3hoot/ATT-Turret-System/hardware/ATT.kicad_sch

## KiCad design hardware/ATT.kicad_sch (2026-10-08, an earlier design)

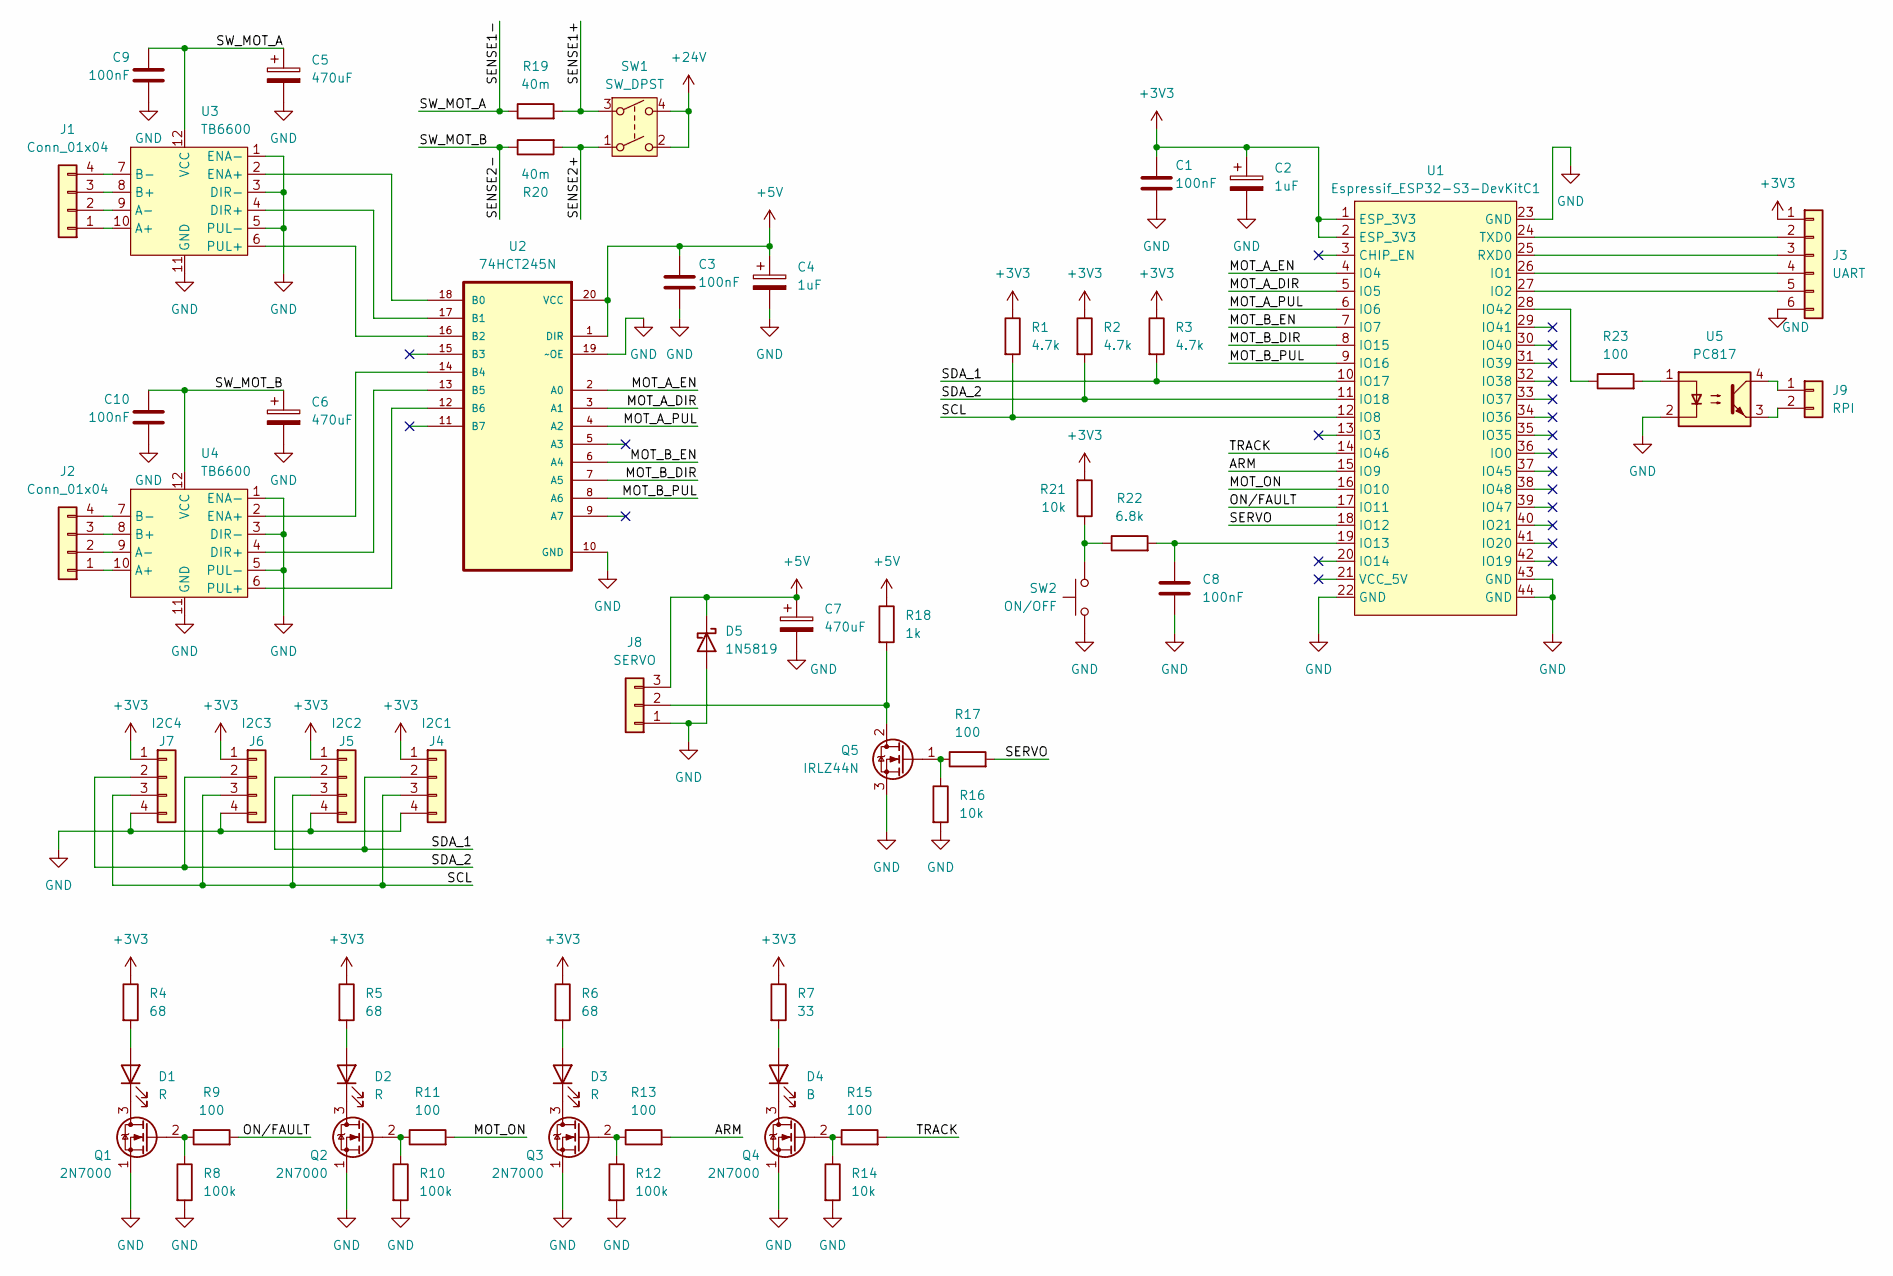
[picture p1: schematic ATT.kicad_sch]

Parts:
C1, C3, C8, C9, C10: 100nF
C2, C4: 1uF
C5, C6, C7: 470uF
D1, D2, D3: R
D4: B
D5: 1N5819; D_DO-41_SOD81_P10.16mm_Horizontal
J1, J2: Conn_01x04
J3: UART
J4: I2C1
J5: I2C2
J6: I2C3
J7: I2C4
J8: SERVO
J9: RPI
Q1, Q2, Q3, Q4: 2N7000; TO-92_Inline
Q5: IRLZ44N; TO-220-3_Vertical
R1, R2, R3: 4.7k
R4, R5, R6: 68
R7: 33
R8, R10, R12: 100k
R9, R11, R13, R15, R17, R23: 100
R14, R16, R21: 10k
R18: 1k
R19, R20: 40m
R22: 6.8k
SW1: SW_DPST
SW2: ON/OFF
U1: Espressif_ESP32-S3-DevKitC1
U2: 74HCT245N; DIP254P762X420-20; MPN 74HCT245N
U3, U4: TB6600
U5: PC817; DIP-4_W7.62mm

Connections:
+3V3: C1.1, C2.1, J3.1, J4.1, J5.1, J6.1, J7.1, R1.1, R2.1, R3.1, R4.1, R5.1, R6.1, R7.1, R21.2, U1.1 (ESP_3V3), U1.2 (ESP_3V3)
+5V: C3.1, C4.1, C7.1, D5.1 (K), J8.3, R18.1, U2.1 (DIR), U2.20 (VCC)
+24V: SW1.2, SW1.4
ARM: R13.2, U1.15 (IO9)
GND: C1.2, C2.2, C3.2, C4.2, C5.2, C6.2, C7.2, C8.2, C9.2, C10.2, D5.2 (A), J3.6, J4.4, J5.4, J6.4, J7.4, J8.1, Q1.1 (S), Q2.1 (S), Q3.1 (S), Q4.1 (S), Q5.3 (S), R8.2, R10.2, R12.2, R14.2, R16.2, SW2.2, U1.22 (GND), U1.23 (GND), U1.43 (GND), U1.44 (GND), U2.10 (GND), U2.19 (~OE), U3.1 (ENA-), U3.3 (DIR-), U3.5 (PUL-), U3.11 (GND), U4.1 (ENA-), U4.3 (DIR-), U4.5 (PUL-), U4.11 (GND), U5.2
MOT_A_DIR: U1.5 (IO5), U2.3 (A1)
MOT_A_EN: U1.4 (IO4), U2.2 (A0)
MOT_A_PUL: U1.6 (IO6), U2.4 (A2)
MOT_B_DIR: U1.8 (IO15), U2.7 (A5)
MOT_B_EN: U1.7 (IO7), U2.6 (A4)
MOT_B_PUL: U1.9 (IO16), U2.8 (A6)
MOT_ON: R11.2, U1.16 (IO10)
unnamed: C8.1, R22.2, U1.19 (IO13)
unnamed: D1.1 (K), Q1.3 (D)
unnamed: D1.2 (A), R4.2
unnamed: D2.1 (K), Q2.3 (D)
unnamed: D2.2 (A), R5.2
unnamed: D3.1 (K), Q3.3 (D)
unnamed: D3.2 (A), R6.2
unnamed: D4.1 (K), Q4.3 (D)
unnamed: D4.2 (A), R7.2
unnamed: J1.1, U3.10 (A+)
unnamed: J1.2, U3.9 (A-)
unnamed: J1.3, U3.8 (B+)
unnamed: J1.4, U3.7 (B-)
unnamed: J2.1, U4.10 (A+)
unnamed: J2.2, U4.9 (A-)
unnamed: J2.3, U4.8 (B+)
unnamed: J2.4, U4.7 (B-)
unnamed: J3.2, U1.24 (TXD0)
unnamed: J3.3, U1.25 (RXD0)
unnamed: J3.4, U1.26 (IO1)
unnamed: J3.5, U1.27 (IO2)
unnamed: J8.2, Q5.2 (D), R18.2
unnamed: J9.1, U5.4
unnamed: J9.2, U5.3
unnamed: Q1.2 (G), R8.1, R9.1
unnamed: Q2.2 (G), R10.1, R11.1
unnamed: Q3.2 (G), R12.1, R13.1
unnamed: Q4.2 (G), R14.1, R15.1
unnamed: Q5.1 (G), R16.1, R17.1
unnamed: R21.1, R22.1, SW2.1
unnamed: R23.1, U1.28 (IO42)
unnamed: R23.2, U5.1
unnamed: U2.12 (B6), U4.6 (PUL+)
unnamed: U2.13 (B5), U4.4 (DIR+)
unnamed: U2.14 (B4), U4.2 (ENA+)
unnamed: U2.16 (B2), U3.6 (PUL+)
unnamed: U2.17 (B1), U3.4 (DIR+)
unnamed: U2.18 (B0), U3.2 (ENA+)
ON/FAULT: R9.2, U1.17 (IO11)
SCL: J4.3, J5.3, J6.3, J7.3, R1.2, U1.12 (IO8)
SDA_1: J4.2, J5.2, R3.2, U1.10 (IO17)
SDA_2: J6.2, J7.2, R2.2, U1.11 (IO18)
SENSE1+: R19.2, SW1.3
SENSE1-: C5.1, C9.1, R19.1, U3.12 (VCC)
SENSE2+: R20.2, SW1.1
SENSE2-: C6.1, C10.1, R20.1, U4.12 (VCC)
SERVO: R17.2, U1.18 (IO12)
TRACK: R15.2, U1.14 (IO46)
