3hoot/ATT-Turret-System/hardware/controller.kicad_sch

## KiCad design hardware/controller.kicad_sch (2026-10-08)

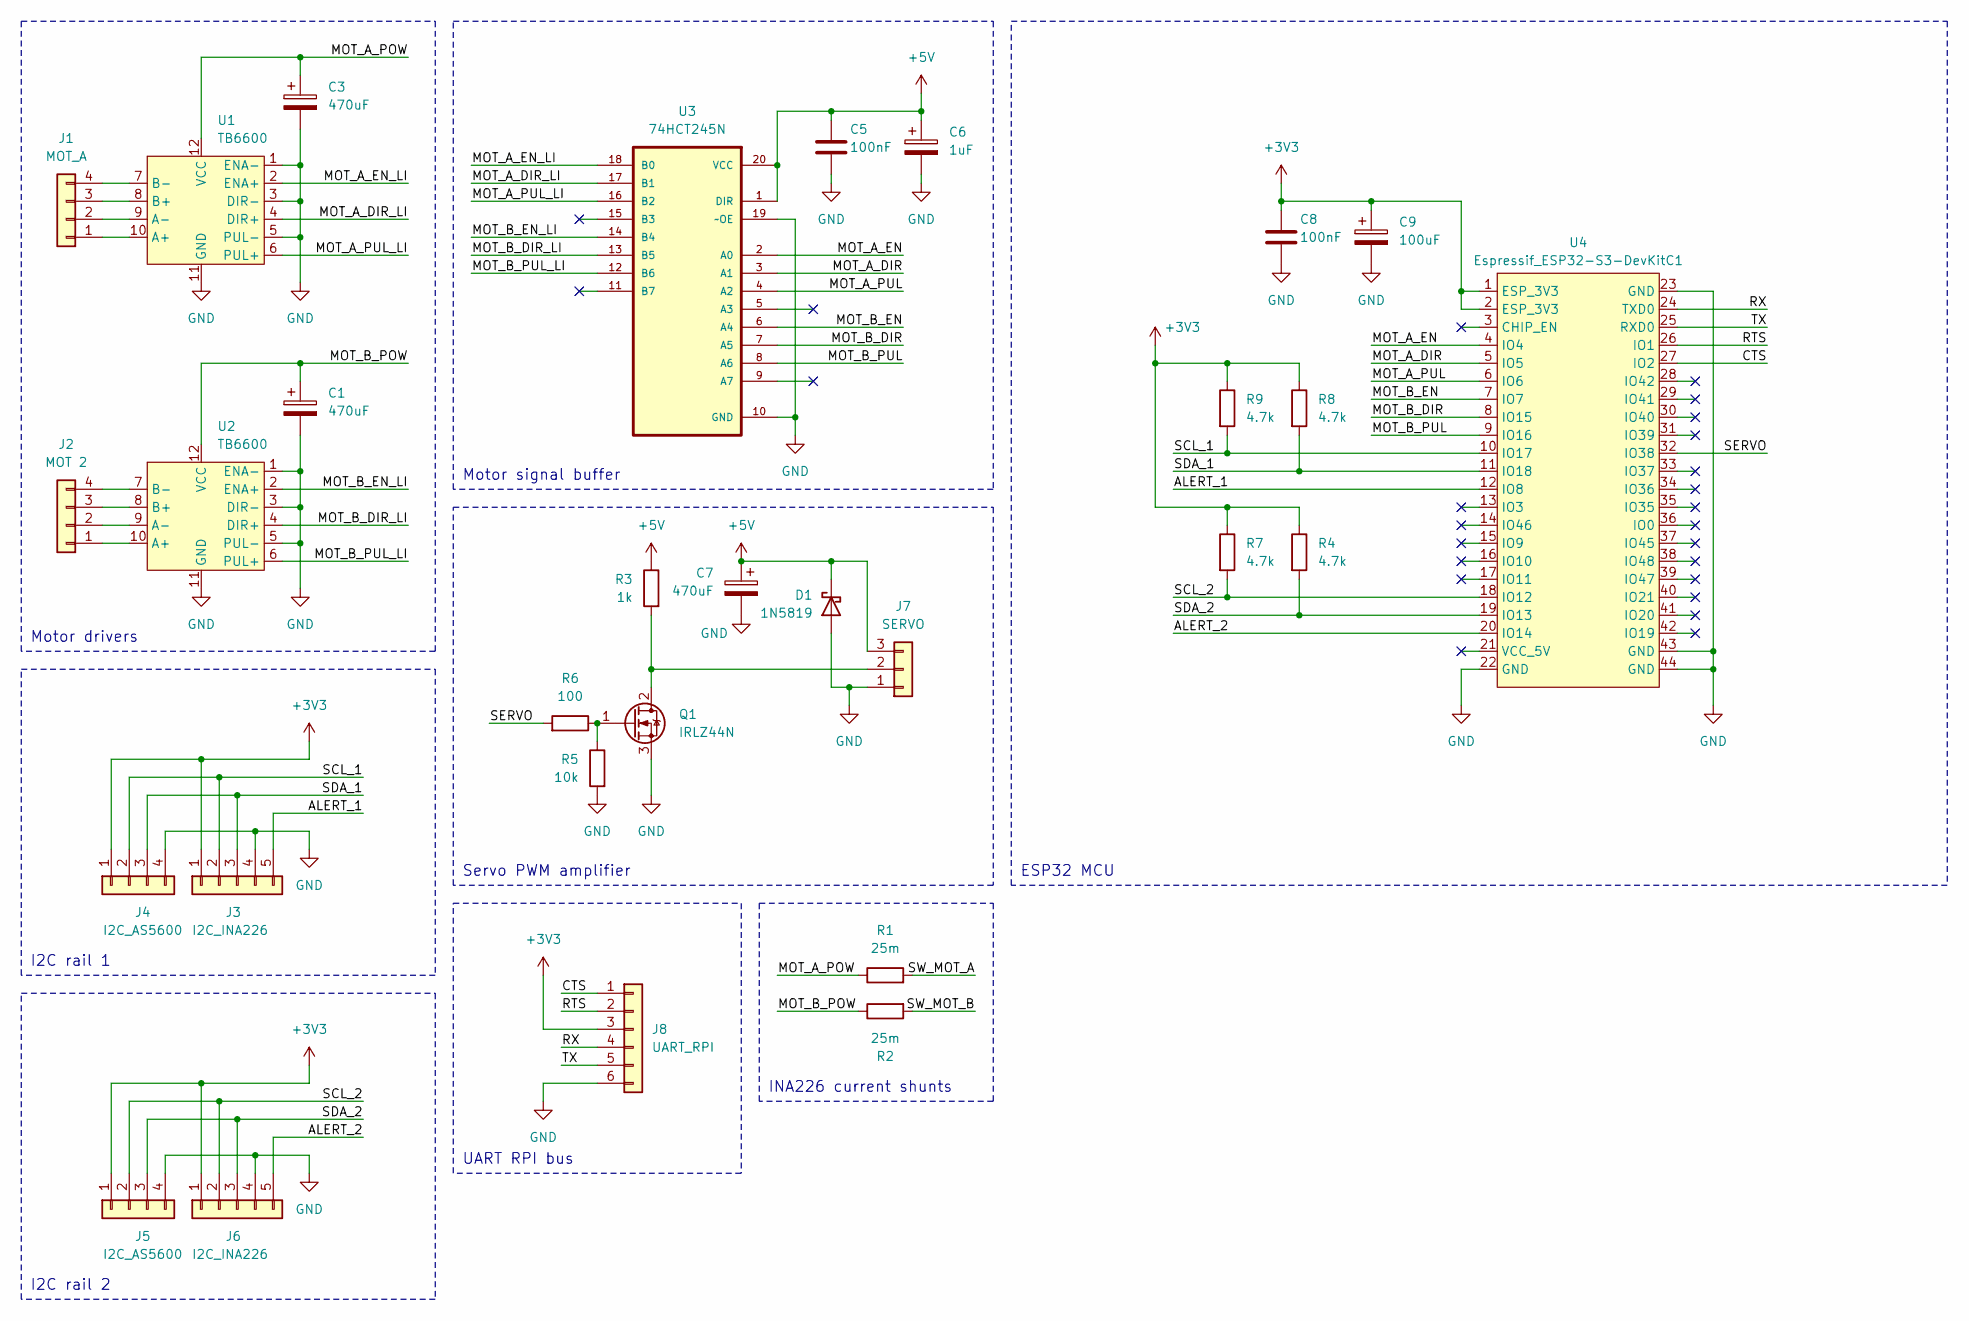
[picture p2: schematic controller.kicad_sch]

Parts:
C1, C3, C7: 470uF
C5, C8: 100nF
C6: 1uF
C9: 100uF
D1: 1N5819; D_DO-41_SOD81_P10.16mm_Horizontal
J1: MOT_A
J2: MOT 2
J3, J6: I2C_INA226
J4, J5: I2C_AS5600
J7: SERVO
J8: UART_RPI
Q1: IRLZ44N; TO-220-3_Vertical
R1, R2: 25m
R3: 1k
R4, R7, R8, R9: 4.7k
R5: 10k
R6: 100
U1, U2: TB6600
U3: 74HCT245N; DIP254P762X420-20; MPN 74HCT245N
U4: Espressif_ESP32-S3-DevKitC1

Connections:
+3V3: C8.1, C9.1, J3.1, J4.1, J5.1, J6.1, J8.3, R4.1, R7.1, R8.1, R9.1, U4.1 (ESP_3V3), U4.2 (ESP_3V3)
+5V: C5.1, C6.1, C7.1, D1.1 (K), J7.3, R3.1, U3.1 (DIR), U3.20 (VCC)
ALERT_1: J3.5, U4.12 (IO8)
ALERT_2: J6.5, U4.20 (IO14)
CTS: J8.1, U4.27 (IO2)
GND: C1.2, C3.2, C5.2, C6.2, C7.2, C8.2, C9.2, D1.2 (A), J3.4, J4.4, J5.4, J6.4, J7.1, J8.6, Q1.3 (S), R5.2, U1.1 (ENA-), U1.3 (DIR-), U1.5 (PUL-), U1.11 (GND), U2.1 (ENA-), U2.3 (DIR-), U2.5 (PUL-), U2.11 (GND), U3.10 (GND), U3.19 (~OE), U4.22 (GND), U4.23 (GND), U4.43 (GND), U4.44 (GND)
MOT_A_DIR: U3.3 (A1), U4.5 (IO5)
MOT_A_DIR_LI: U1.4 (DIR+), U3.17 (B1)
MOT_A_EN: U3.2 (A0), U4.4 (IO4)
MOT_A_EN_LI: U1.2 (ENA+), U3.18 (B0)
MOT_A_POW: C3.1, R1.1, U1.12 (VCC)
MOT_A_PUL: U3.4 (A2), U4.6 (IO6)
MOT_A_PUL_LI: U1.6 (PUL+), U3.16 (B2)
MOT_B_DIR: U3.7 (A5), U4.8 (IO15)
MOT_B_DIR_LI: U2.4 (DIR+), U3.13 (B5)
MOT_B_EN: U3.6 (A4), U4.7 (IO7)
MOT_B_EN_LI: U2.2 (ENA+), U3.14 (B4)
MOT_B_POW: C1.1, R2.1, U2.12 (VCC)
MOT_B_PUL: U3.8 (A6), U4.9 (IO16)
MOT_B_PUL_LI: U2.6 (PUL+), U3.12 (B6)
unnamed: J1.1, U1.10 (A+)
unnamed: J1.2, U1.9 (A-)
unnamed: J1.3, U1.8 (B+)
unnamed: J1.4, U1.7 (B-)
unnamed: J2.1, U2.10 (A+)
unnamed: J2.2, U2.9 (A-)
unnamed: J2.3, U2.8 (B+)
unnamed: J2.4, U2.7 (B-)
unnamed: J7.2, Q1.2 (D), R3.2
unnamed: Q1.1 (G), R5.1, R6.1
RTS: J8.2, U4.26 (IO1)
RX: J8.4, U4.24 (TXD0)
SCL_1: J3.2, J4.2, R9.2, U4.10 (IO17)
SCL_2: J5.2, J6.2, R7.2, U4.18 (IO12)
SDA_1: J3.3, J4.3, R8.2, U4.11 (IO18)
SDA_2: J5.3, J6.3, R4.2, U4.19 (IO13)
SERVO: R6.2, U4.32 (IO38)
SW_MOT_A: R1.2
SW_MOT_B: R2.2
TX: J8.5, U4.25 (RXD0)

Notes on the sheet:
I2C rail 2
ESP32 MCU
Servo PWM amplifier
UART RPI bus
Motor drivers
INA226 current shunts
I2C rail 1
Motor signal buffer
