3hoot/ATT-Turret-System/hardware/power.kicad_sch

## KiCad design hardware/power.kicad_sch (2026-10-08)

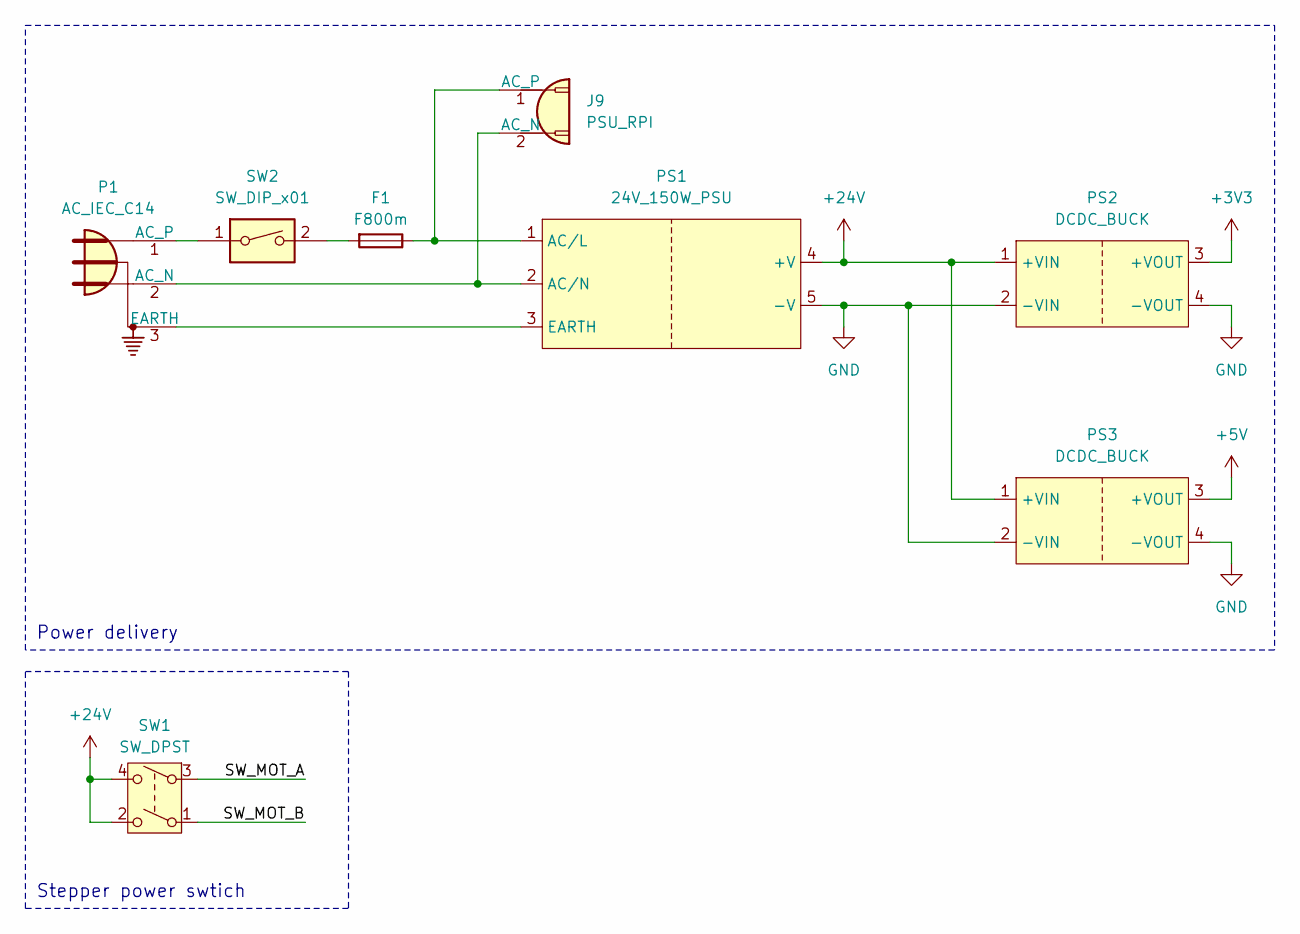
[picture p3: schematic power.kicad_sch]

Parts:
F1: F800m
J9: PSU_RPI
P1: AC_IEC_C14
PS1: 24V_150W_PSU
PS2, PS3: DCDC_BUCK
SW1: SW_DPST
SW2: SW_DIP_x01

Connections:
+3V3: PS2.3 (+VOUT)
+5V: PS3.3 (+VOUT)
+24V: PS1.4 (+V), PS2.1 (+VIN), PS3.1 (+VIN), SW1.2, SW1.4
GND: PS1.5 (-V), PS2.2 (-VIN), PS2.4 (-VOUT), PS3.2 (-VIN), PS3.4 (-VOUT)
unnamed: F1.1, J9.1 (AC_P), PS1.1 (AC/L)
unnamed: F1.2, SW2.2
unnamed: J9.2 (AC_N), P1.2 (AC_N), PS1.2 (AC/N)
unnamed: P1.1 (AC_P), SW2.1
unnamed: P1.3 (EARTH), PS1.3 (EARTH)
SW_MOT_A: SW1.3
SW_MOT_B: SW1.1

Notes on the sheet:
Power delivery
Stepper power swtich
