3hoot/ATT-Turret-System/(commit log)

2026-08-27 Working communication between the PC and ESP, ported odl analysis and created general electronics schematics
    [ATT.kicad_pcb, ATT.kicad_sch, partitions.csv]
2026-09-19 Fixed bugs in framed_serial, added low-level stepper control via stepper_driver
    [app_config.h, app_main.c, framed_serial.c, framed_serial.h, stepper_driver.c, stepper_driver.h]
2026-10-08 Finalized-ish electronic hardware schematics
    [ATT.kicad_sch, controller.kicad_sch, power.kicad_sch]
2026-10-13 Added I2C buses alongside position and current sensors, moved things around, re-did stepper handling
2026-10-17 Fixed I2C bus occupancy bug
